Patsch91/8Iaxe/8IAxe/3d/barrel-jack.step

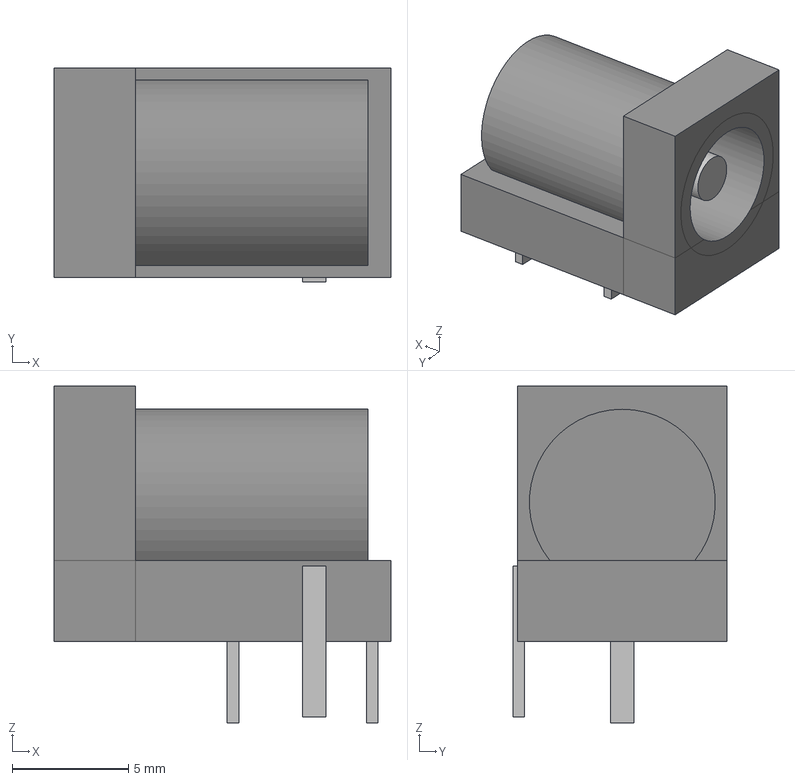
[picture p3: CAD file, 2024-06-30]
8IAxe/3d/barrel-jack.step
14.5 x 9.20 x 14.5 mm
