Patsch91/8Iaxe/8IAxe/3d/4pin-connector.step

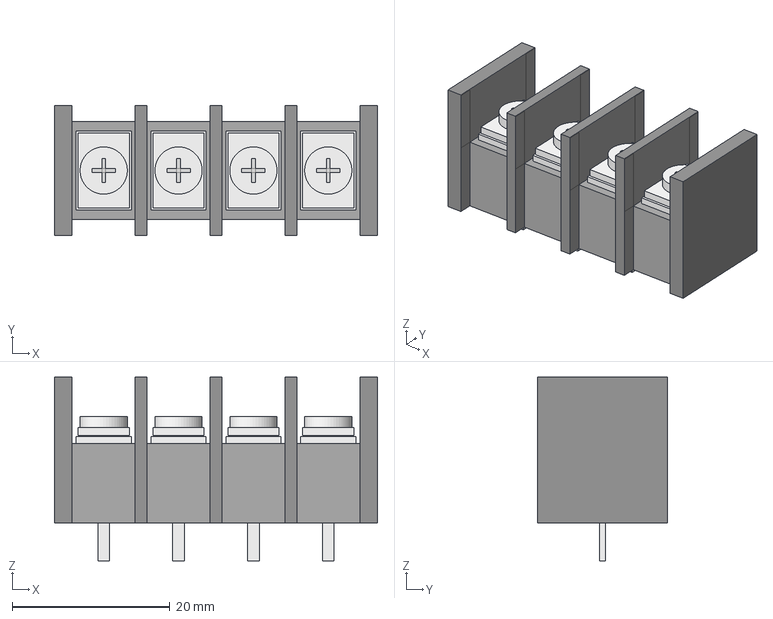
[picture p4: CAD file, 2024-06-30]
8IAxe/3d/4pin-connector.step
41.0 x 16.5 x 23.3 mm
