Patsch91/8Iaxe/8IAxe/3d/bm1366.step

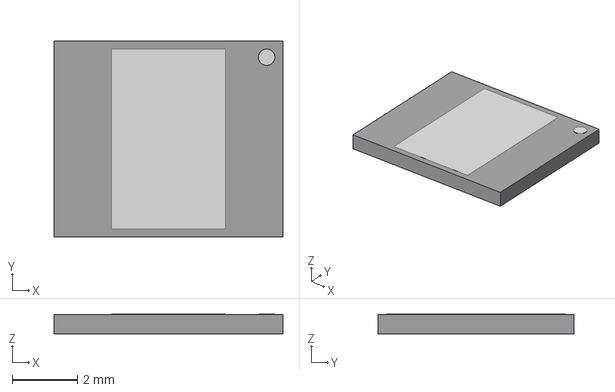
[picture p5: CAD file, 2024-06-30]
8IAxe/3d/bm1366.step
7.00 x 6.00 x 0.61 mm
