Patsch91/8Iaxe/8IAxe/8]axe.kicad_sch

## KiCad design 8IAxe/8]axe.kicad_sch (2024-08-08)

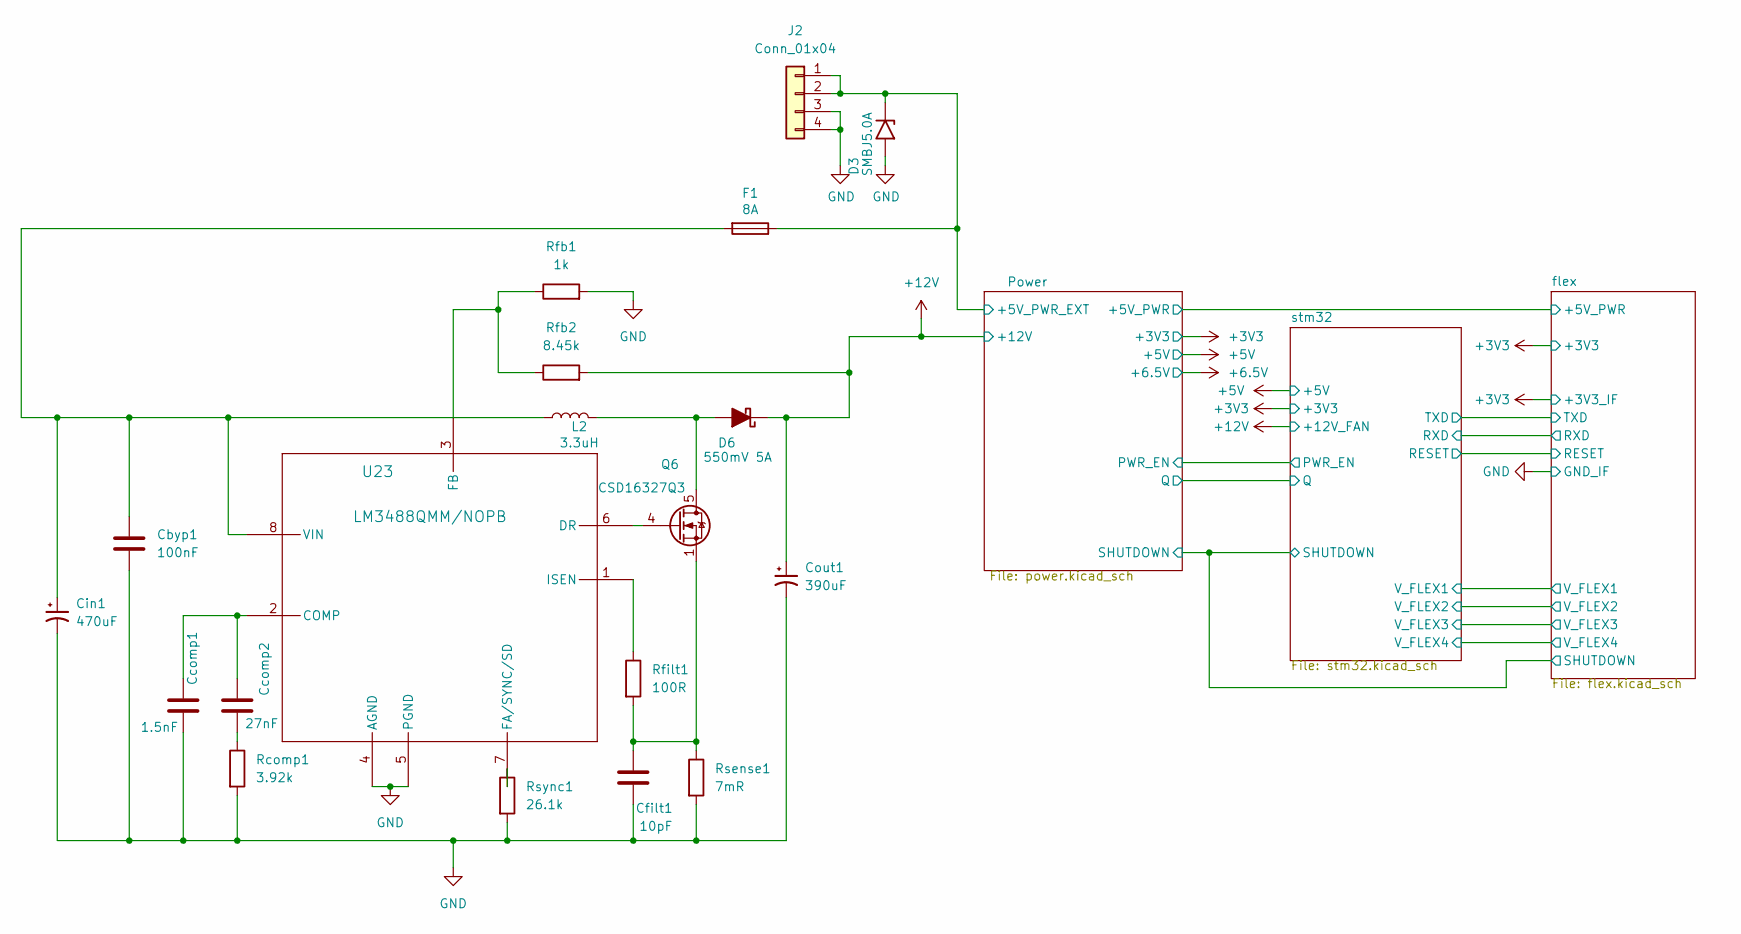
[picture p6: schematic 8]axe.kicad_sch]

Parts:
Cbyp1: 100nF; C_0603_1608Metric; MPN GRM188R70J104KA01D
Ccomp1: 1.5nF; C_0603_1608Metric; MPN GRM1885C1H152JA01D
Ccomp2: 27nF; C_0603_1608Metric
Cfilt1: 10pF; C_0805_2012Metric; MPN CC0805JRNPO9BN100
Cin1: 470uF; CP_Elec_10x10.5; MPN UUD1E471MNL1GS
Cout1: 390uF; PCAP_SVP_E12_PAN; MPN 20SVPF390M
D3: SMBJ5.0A; D_SMB
D6: 550mV 5A; SMC_DIO; MPN B540C-13-F
F1: 8A; 0154Series_LTF
J2: Conn_01x04; Barrier Terminal 01x04
L2: 3.3uH; IND_WE-CHSA-SMT_1011_WRE; MPN 7843330330
Q6: CSD16327Q3; VSON-8_3.3x3.3mm_P0.65mm_NexFET
Rcomp1: 3.92k; R_0603_1608Metric; MPN RC0603FR-073K92L
Rfb1: 1k; R_0603_1608Metric; MPN CRCW06031K00FKEA
Rfb2: 8.45k; R_0603_1608Metric; MPN RC0603FR-078K45L
Rfilt1: 100R; R_0603_1608Metric; MPN RC0603FR-07100RL
Rsense1: 7mR; RES_3216_SUS; MPN PRL1632-R007-F-T1
Rsync1: 26.1k; R_0603_1608Metric; MPN RC0603FR-0726K1L
U23: LM3488QMM/NOPB; DGK8; MPN LM3488QMM/NOPB

Connections:
+5V_PWR_EXT: D3.1 (A1), F1.1, J2.1, J2.2
+12V: Cout1.1, D6.1 (K), Rfb2.2
GND: Cbyp1.2, Ccomp1.2, Cfilt1.2, Cin1.2, Cout1.2, D3.2 (A2), J2.3, J2.4, Rcomp1.2, Rfb1.2, Rsense1.2, Rsync1.2, U23.4 (AGND), U23.5 (PGND)
unnamed: Cbyp1.1, Cin1.1, F1.2, L2.1, U23.8 (VIN)
unnamed: Ccomp1.1, Ccomp2.1, U23.2 (COMP)
unnamed: Ccomp2.2, Rcomp1.1
unnamed: Cfilt1.1, Q6.1 (S), Q6.2 (S), Q6.3 (S), Rfilt1.2, Rsense1.1
unnamed: D6.2 (A), L2.2, Q6.5 (D)
unnamed: Q6.4 (G), U23.6 (DR)
unnamed: Rfb1.1, Rfb2.1, U23.3 (FB)
unnamed: Rfilt1.1, U23.1 (ISEN)
unnamed: Rsync1.1, U23.7 (FA/SYNC/SD)
