Patsch91/8Iaxe/8IAxe/flex1.kicad_sch

## KiCad design 8IAxe/flex1.kicad_sch (2024-08-08)

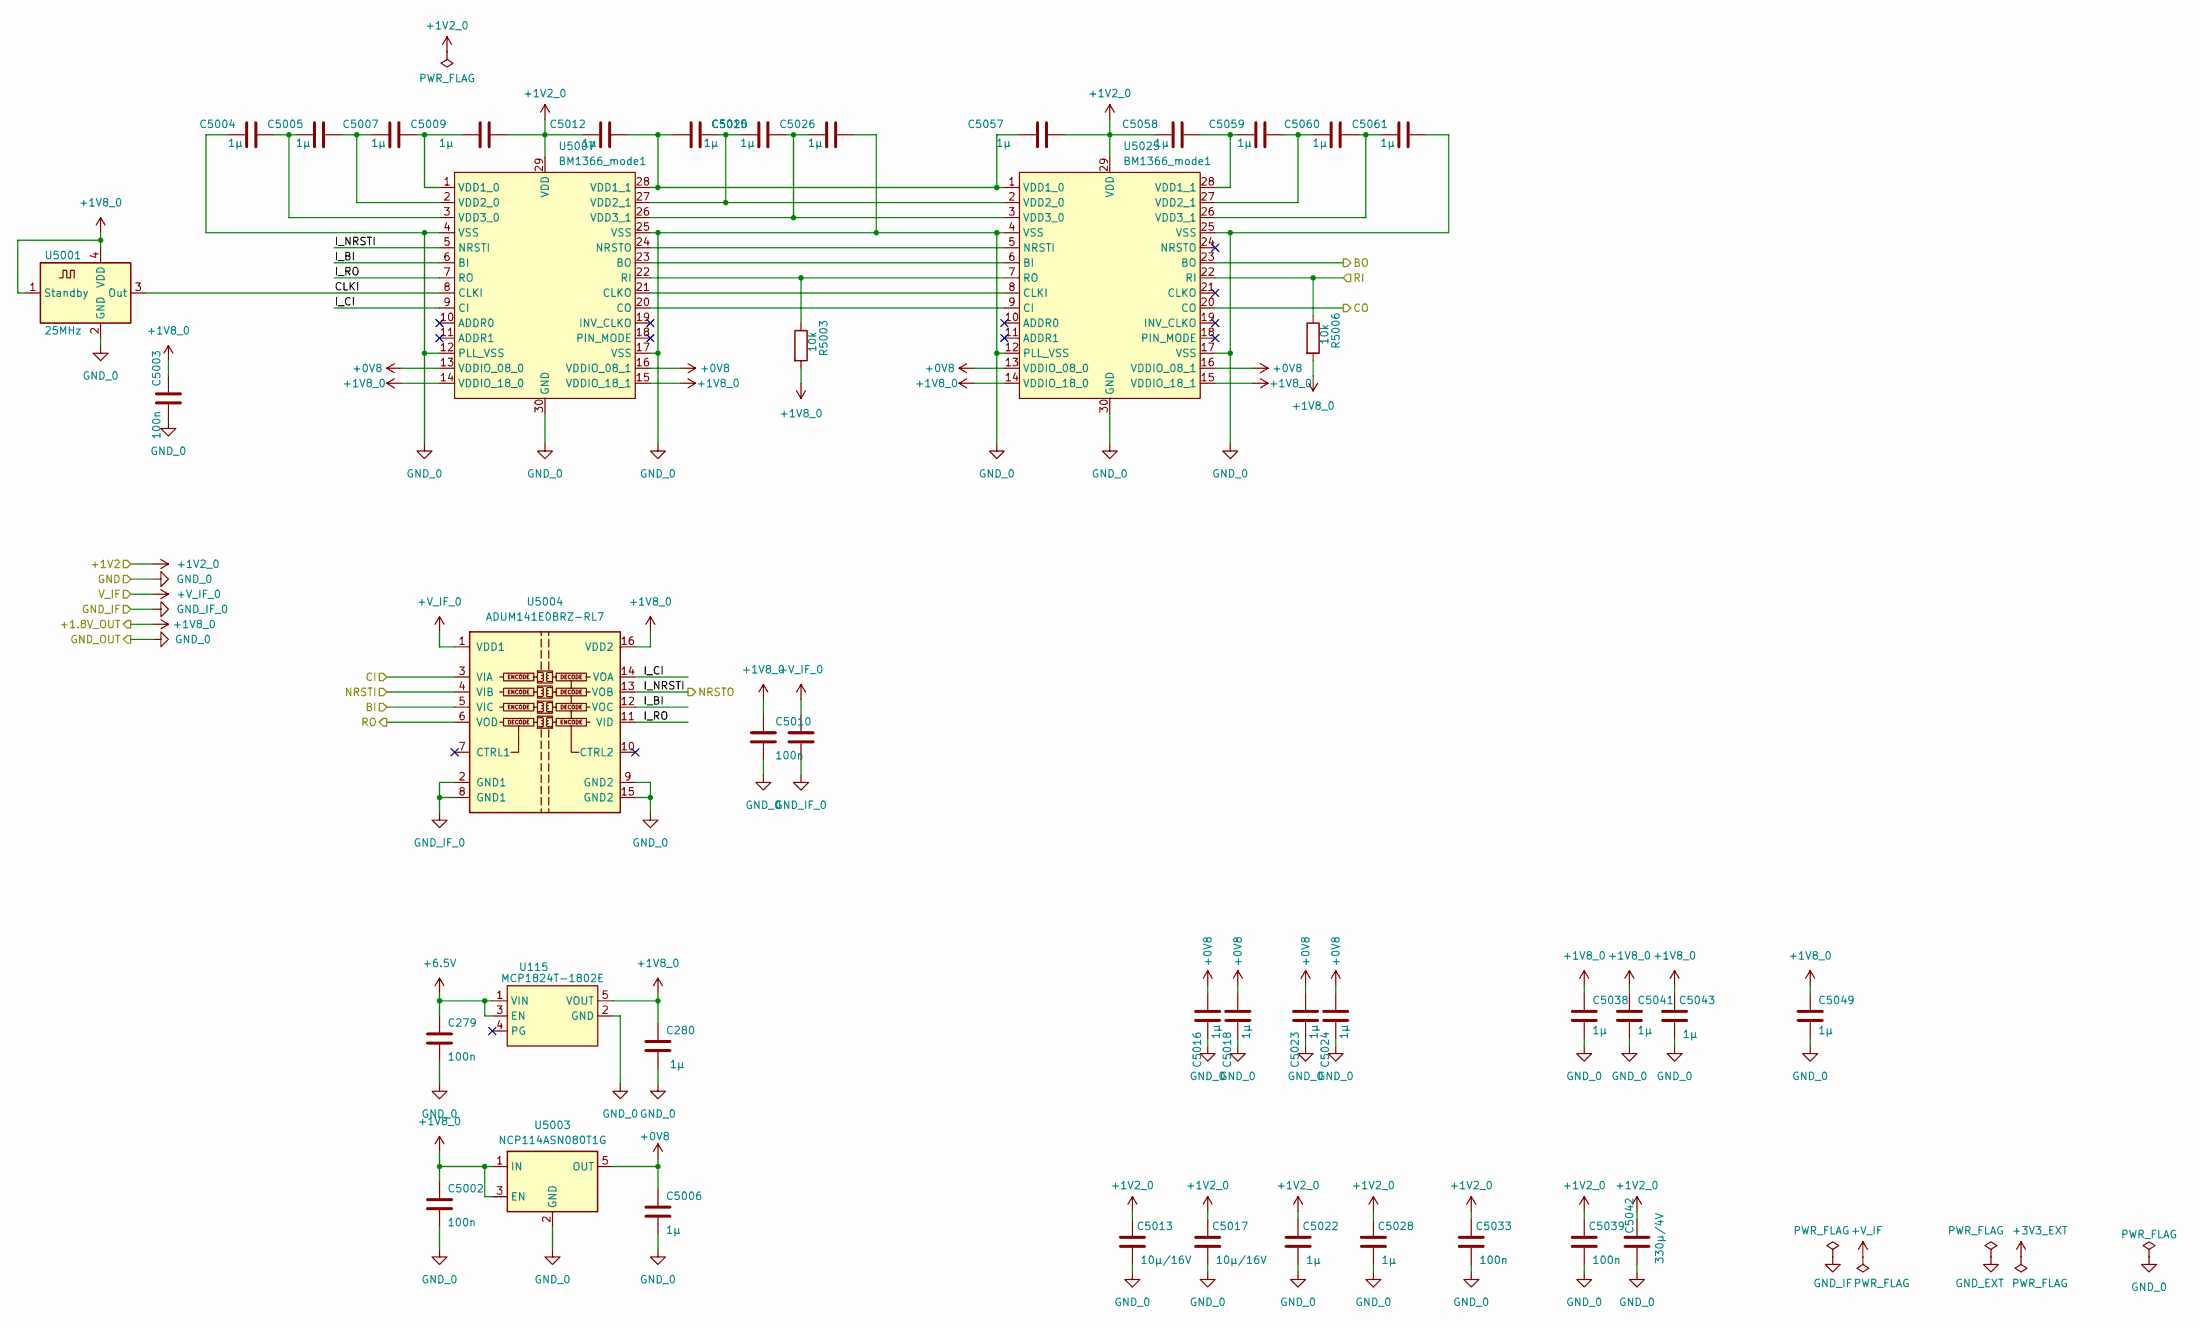
[picture p7: schematic flex1.kicad_sch]

Parts:
C279, C5002, C5003, C5010, C5011, C5033, C5039: 100n; C_0603_1608Metric
C280, C5004, C5005, C5006, C5007, C5009, C5012, C5015, C5016, C5018, C5020, C5022, C5023, C5024, C5026, C5028, C5038, C5041, C5043, C5049, C5057, C5058, C5059, C5060, C5061: 1µ; C_0603_1608Metric
C5013, C5017: 10µ/16V; C_0603_1608Metric
C5042: 330µ/4V; C_1210_3225Metric
R5003, R5006: 10k; R_0603_1608Metric
U115: MCP1824T-1802E; SOT-23-5
U5001: 25MHz; Oscillator_SMD_EuroQuartz_XO32-4Pin_3.2x2.5mm
U5003: NCP114ASN080T1G; SOT-23-5
U5004: ADUM141E0BRZ-RL7; SOIC-16_3.9x9.9mm_P1.27mm
U5005, U5006, U5008, U5009, U5010, U5012, U5013, U5024, U5026: +0V8
U5007, U5025: BM1366_mode1; BM1366

Connections:
+1V2_0: C5009.2, C5012.1, C5013.1, C5017.1, C5022.1, C5028.1, C5033.1, C5039.1, C5042.1, C5057.2, C5058.1, U5007.29 (VDD), U5025.29 (VDD)
+1V8_0: C280.1, C5002.1, C5003.1, C5010.1, C5038.1, C5041.1, C5043.1, C5049.1, R5003.2, R5006.2, U115.5 (VOUT), U5001.1 (Standby), U5001.4 (VDD), U5003.1 (IN), U5003.3 (EN), U5004.16 (VDD2), U5007.14 (VDDIO_18_0), U5007.15 (VDDIO_18_1), U5025.14 (VDDIO_18_0), U5025.15 (VDDIO_18_1)
+6.5V: C279.1, U115.1 (VIN), U115.3 (EN)
+V_IF_0: C5011.1, U5004.1 (VDD1)
BI: U5004.5 (VIC)
BO: U5025.23 (BO)
CI: U5004.3 (VIA)
CLKI: U5001.3 (Out), U5007.8 (CLKI)
CO: U5025.20 (CO)
GND_0: C279.2, C280.2, C5002.2, C5003.2, C5004.1, C5006.2, C5010.2, C5013.2, C5016.1, C5017.2, C5018.1, C5022.2, C5023.1, C5024.1, C5026.2, C5028.2, C5033.2, C5038.2, C5039.2, C5041.2, C5042.2, C5043.2, C5049.2, C5061.2, U115.2 (GND), U5001.2 (GND), U5003.2 (GND), U5004.9 (GND2), U5004.15 (GND2), U5007.4 (VSS), U5007.12 (PLL_VSS), U5007.17 (VSS), U5007.25 (VSS), U5007.30 (GND), U5025.4 (VSS), U5025.12 (PLL_VSS), U5025.17 (VSS), U5025.25 (VSS), U5025.30 (GND)
GND_IF_0: C5011.2, U5004.2 (GND1), U5004.8 (GND1)
I_BI: U5004.12 (VOC), U5007.6 (BI)
I_CI: U5004.14 (VOA), U5007.9 (CI)
I_NRSTI: U5004.13 (VOB), U5007.5 (NRSTI)
I_RO: U5004.11 (VID), U5007.7 (RO)
NRSTI: U5004.4 (VIB)
unnamed: C5004.2, C5005.1, U5007.3 (VDD3_0)
unnamed: C5005.2, C5007.1, U5007.2 (VDD2_0)
unnamed: C5006.1, U5003.5 (OUT), U5005.1
unnamed: C5007.2, C5009.1, U5007.1 (VDD1_0)
unnamed: C5012.2, C5015.2, C5057.1, U5007.28 (VDD1_1), U5025.1 (VDD1_0)
unnamed: C5015.1, C5020.1, U5007.27 (VDD2_1), U5025.2 (VDD2_0)
unnamed: C5016.2, U5009.1
unnamed: C5018.2, U5010.1
unnamed: C5020.2, C5026.1, U5007.26 (VDD3_1), U5025.3 (VDD3_0)
unnamed: C5023.2, U5012.1
unnamed: C5024.2, U5013.1
unnamed: C5058.2, C5059.1, U5025.28 (VDD1_1)
unnamed: C5059.2, C5060.1, U5025.27 (VDD2_1)
unnamed: C5060.2, C5061.1, U5025.26 (VDD3_1)
unnamed: R5003.1, U5007.22 (RI), U5025.7 (RO)
unnamed: U5006.1, U5007.13 (VDDIO_08_0)
unnamed: U5007.16 (VDDIO_08_1), U5008.1
unnamed: U5007.20 (CO), U5025.9 (CI)
unnamed: U5007.21 (CLKO), U5025.8 (CLKI)
unnamed: U5007.23 (BO), U5025.6 (BI)
unnamed: U5007.24 (NRSTO), U5025.5 (NRSTI)
unnamed: U5024.1, U5025.13 (VDDIO_08_0)
unnamed: U5025.16 (VDDIO_08_1), U5026.1
RI: R5006.1, U5025.22 (RI)
RO: U5004.6 (VOD)
