Patsch91/8Iaxe/8IAxe/flex4.kicad_sch

## KiCad design 8IAxe/flex4.kicad_sch (2024-08-08)

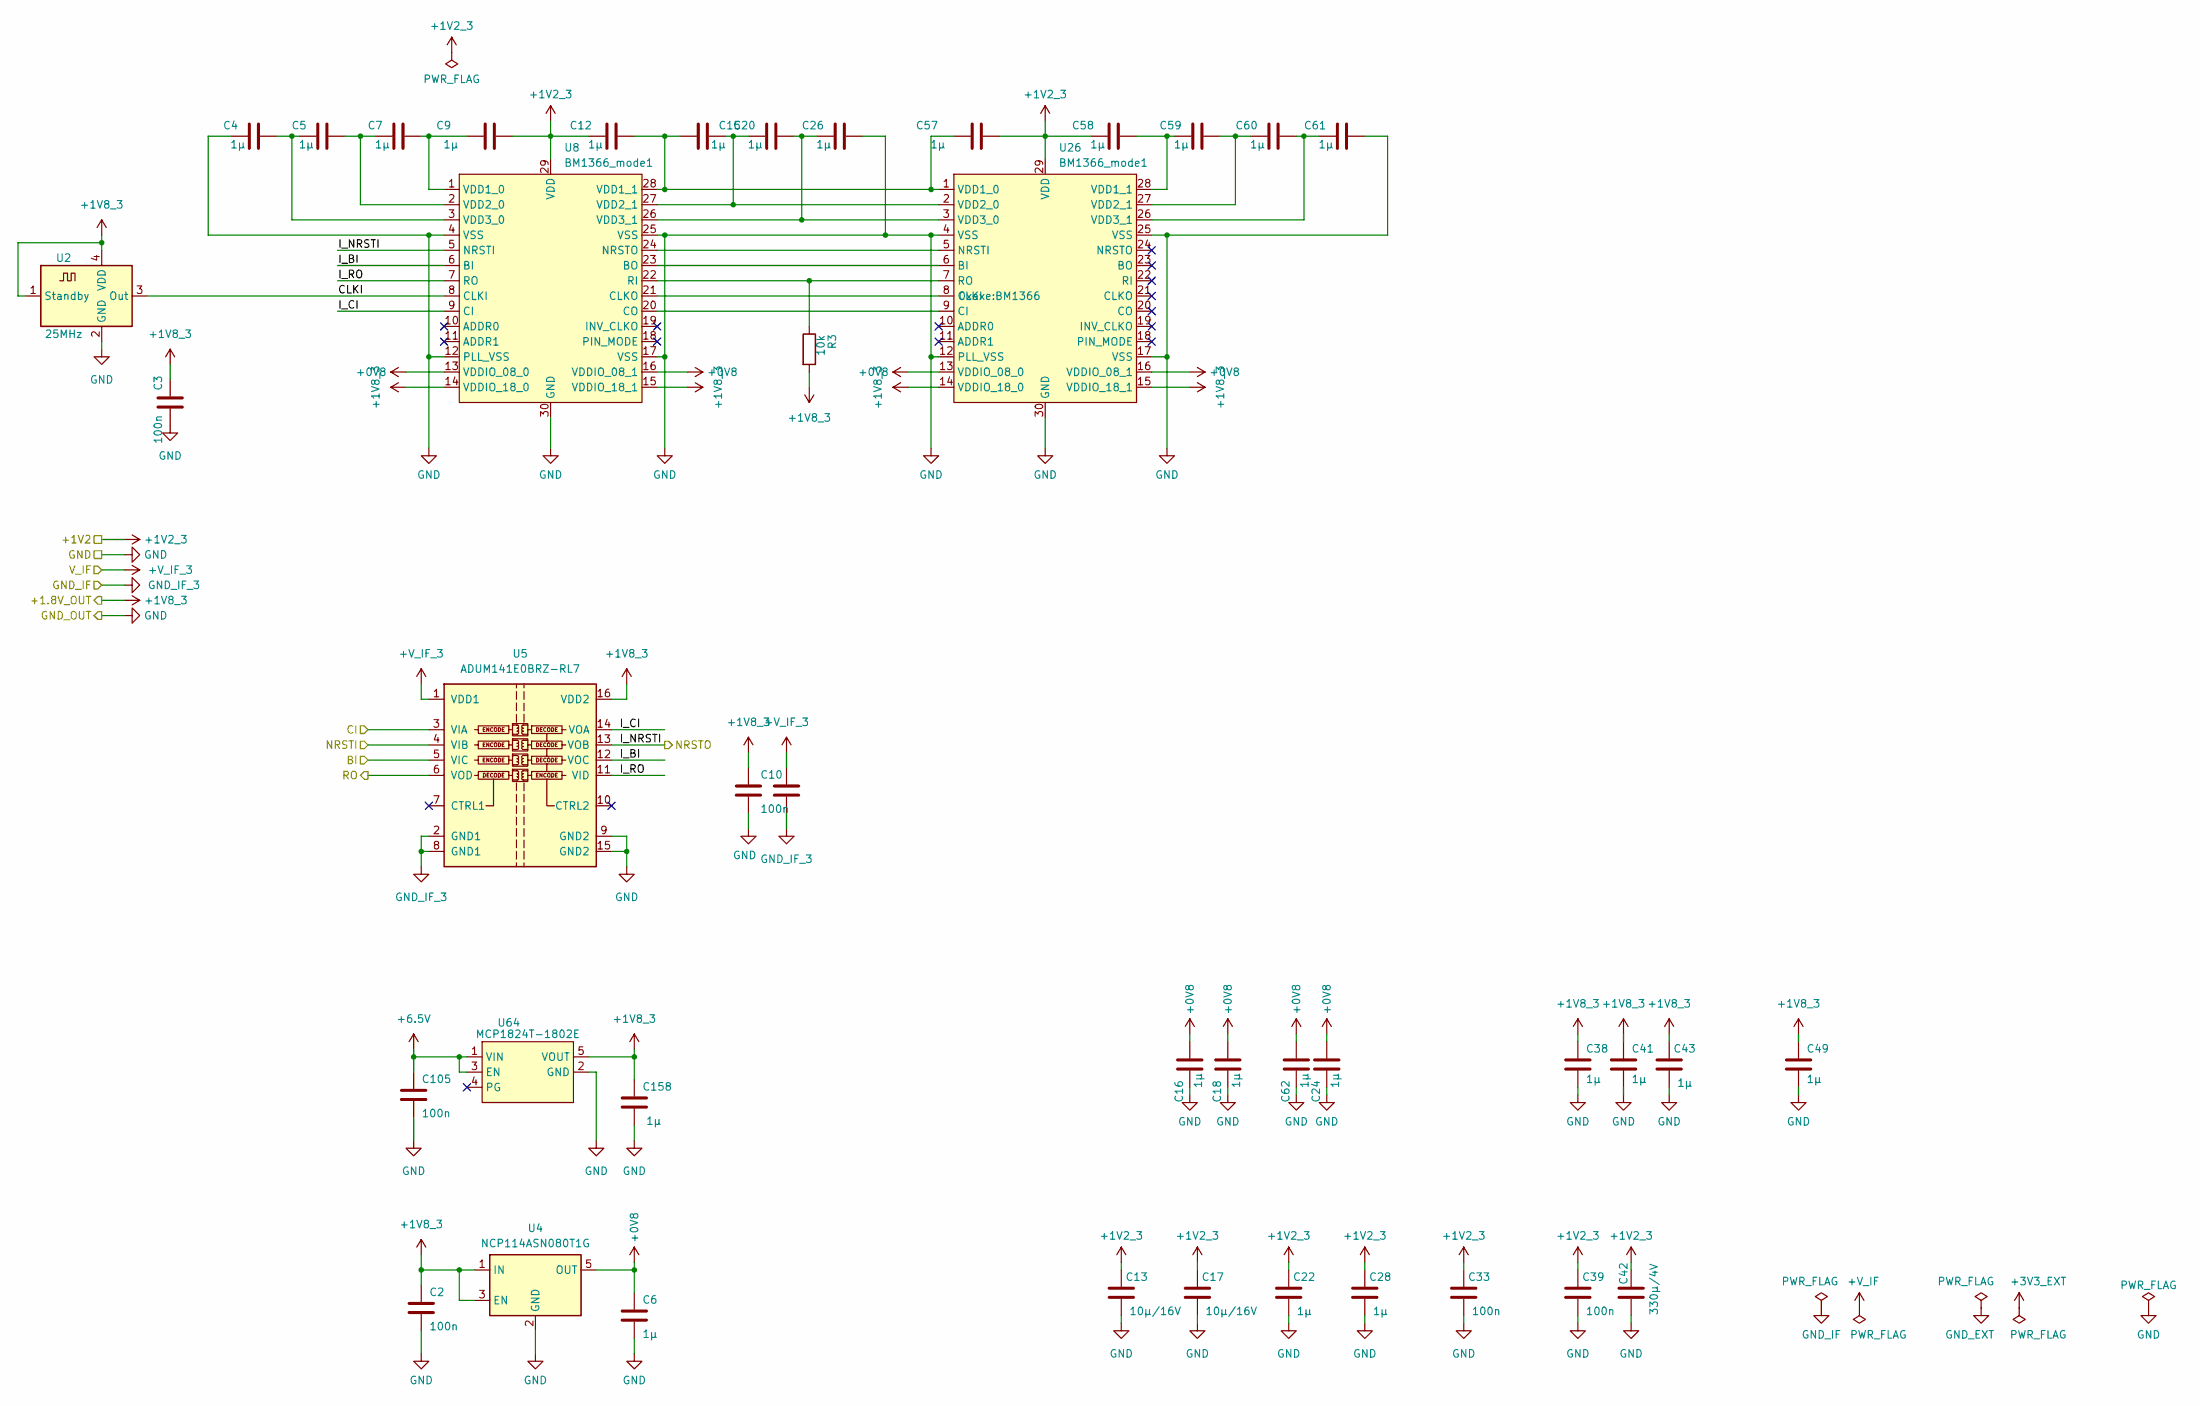
[picture p10: schematic flex4.kicad_sch]

Parts:
C2, C3, C10, C11, C33, C39, C105: 100n; C_0603_1608Metric
C4, C5, C6, C7, C9, C12, C15, C16, C18, C20, C22, C24, C26, C28, C38, C41, C43, C49, C57, C58, C59, C60, C61, C62, C158: 1µ; C_0603_1608Metric
C13, C17: 10µ/16V; C_0603_1608Metric
C42: 330µ/4V; C_1210_3225Metric
R3: 10k; R_0603_1608Metric
U2: 25MHz; Oscillator_SMD_EuroQuartz_XO32-4Pin_3.2x2.5mm
U4: NCP114ASN080T1G; SOT-23-5
U5: ADUM141E0BRZ-RL7; SOIC-16_3.9x9.9mm_P1.27mm
U6, U7, U9, U10, U11, U13, U14, U25, U27: +0V8
U8, U26: BM1366_mode1; BM1366
U64: MCP1824T-1802E; SOT-23-5

Connections:
+1V2_3: C9.2, C12.1, C13.1, C17.1, C22.1, C28.1, C33.1, C39.1, C42.1, C57.2, C58.1, U8.29 (VDD), U26.29 (VDD)
+1V8_3: C2.1, C3.1, C10.1, C38.1, C41.1, C43.1, C49.1, C158.1, R3.2, U2.1 (Standby), U2.4 (VDD), U4.1 (IN), U4.3 (EN), U5.16 (VDD2), U8.14 (VDDIO_18_0), U8.15 (VDDIO_18_1), U26.14 (VDDIO_18_0), U26.15 (VDDIO_18_1), U64.5 (VOUT)
+6.5V: C105.1, U64.1 (VIN), U64.3 (EN)
+V_IF_3: C11.1, U5.1 (VDD1)
BI: U5.5 (VIC)
CI: U5.3 (VIA)
CLKI: U2.3 (Out), U8.8 (CLKI)
GND: C2.2, C3.2, C4.1, C6.2, C10.2, C13.2, C16.1, C17.2, C18.1, C22.2, C24.1, C26.2, C28.2, C33.2, C38.2, C39.2, C41.2, C42.2, C43.2, C49.2, C61.2, C62.1, C105.2, C158.2, U2.2 (GND), U4.2 (GND), U5.9 (GND2), U5.15 (GND2), U8.4 (VSS), U8.12 (PLL_VSS), U8.17 (VSS), U8.25 (VSS), U8.30 (GND), U26.4 (VSS), U26.12 (PLL_VSS), U26.17 (VSS), U26.25 (VSS), U26.30 (GND), U64.2 (GND)
GND_IF_3: C11.2, U5.2 (GND1), U5.8 (GND1)
I_BI: U5.12 (VOC), U8.6 (BI)
I_CI: U5.14 (VOA), U8.9 (CI)
I_NRSTI: U5.13 (VOB), U8.5 (NRSTI)
I_RO: U5.11 (VID), U8.7 (RO)
NRSTI: U5.4 (VIB)
unnamed: C4.2, C5.1, U8.3 (VDD3_0)
unnamed: C5.2, C7.1, U8.2 (VDD2_0)
unnamed: C6.1, U4.5 (OUT), U6.1
unnamed: C7.2, C9.1, U8.1 (VDD1_0)
unnamed: C12.2, C15.2, C57.1, U8.28 (VDD1_1), U26.1 (VDD1_0)
unnamed: C15.1, C20.1, U8.27 (VDD2_1), U26.2 (VDD2_0)
unnamed: C16.2, U10.1
unnamed: C18.2, U11.1
unnamed: C20.2, C26.1, U8.26 (VDD3_1), U26.3 (VDD3_0)
unnamed: C24.2, U14.1
unnamed: C58.2, C59.1, U26.28 (VDD1_1)
unnamed: C59.2, C60.1, U26.27 (VDD2_1)
unnamed: C60.2, C61.1, U26.26 (VDD3_1)
unnamed: C62.2, U13.1
unnamed: R3.1, U8.22 (RI), U26.7 (RO)
unnamed: U7.1, U8.13 (VDDIO_08_0)
unnamed: U8.16 (VDDIO_08_1), U9.1
unnamed: U25.1, U26.13 (VDDIO_08_0)
unnamed: U8.24 (NRSTO), U26.5 (NRSTI)
unnamed: U8.23 (BO), U26.6 (BI)
unnamed: U8.21 (CLKO), U26.8 (CLKI)
unnamed: U8.20 (CO), U26.9 (CI)
unnamed: U26.16 (VDDIO_08_1), U27.1
RO: U5.6 (VOD)
